Destination-SPACE/Rover/README.md

# Rover
Check out the [wiki](https://github.com/Destination-SPACE/Rover-v1/wiki) for step-by-step instructions.

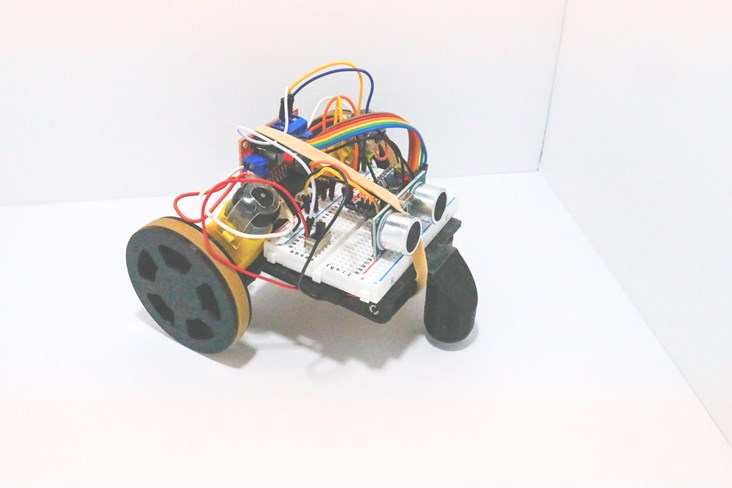
[picture p1: assets/finishedRover.jpg]
