Destination-SPACE/Rover/cad/README.md

# Rover CAD
All of the CAD files for this platform
## STLs
* [Chassis](https://github.com/Destination-SPACE/Rover-v1/tree/main/cad/final_chassis.stl)
* [Wheels](https://github.com/Destination-SPACE/Rover-v1/tree/main/cad/wheel_v4.2.stl)
## Inventor Files
* [Wheels](https://github.com/Destination-SPACE/Rover-v1/tree/main/cad/wheel_v4.2_inv.ipt)
