Destination-SPACE/Rover/code/README.md

# Robot Code
* Sample_3A: Drives forward until distance is < 15cm
* Sample_3B: Drives forward until distance is < 12cm and turns. Set up to be modified to solve maze
