Destination-SPACE/Rover/assets/batteryWires.jpg

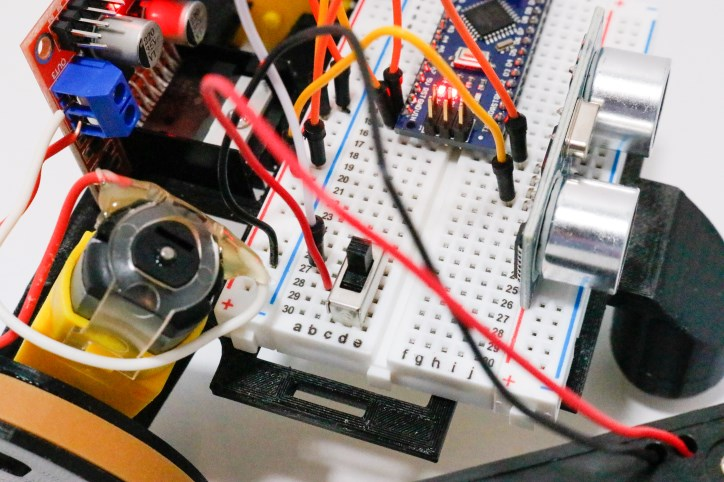
assets/batteryWires.jpg
