Destination-SPACE/Rover/assets/insertingMotors.jpg

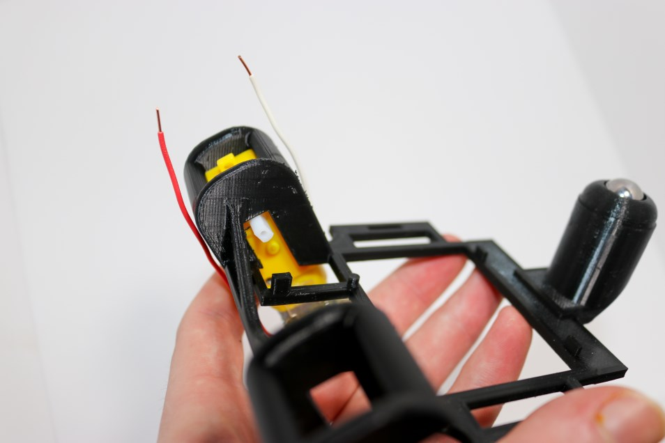
assets/insertingMotors.jpg
