Destination-SPACE/Rover/assets/powerWires.jpg

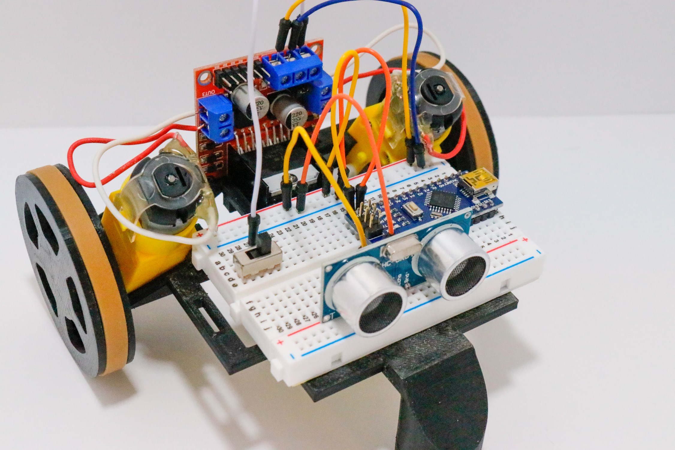
assets/powerWires.jpg
