Destination-SPACE/Rover/assets/schematic.PNG

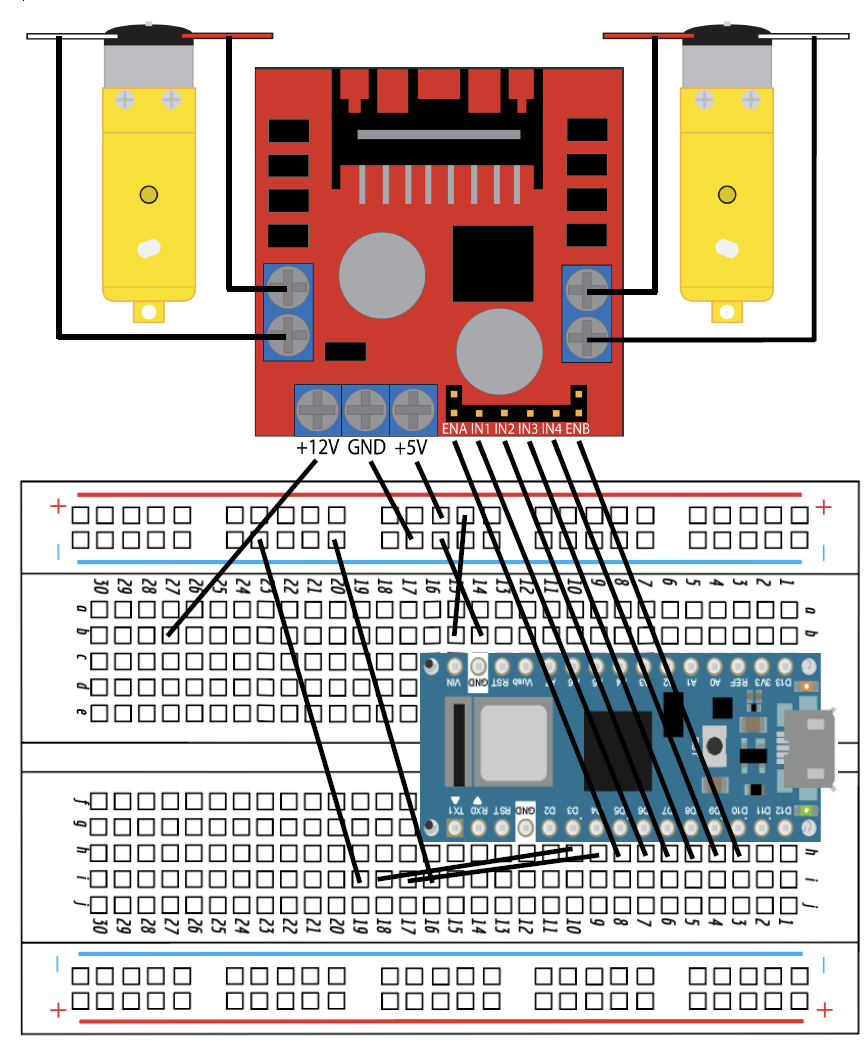
assets/schematic.PNG
