Destination-SPACE/Rover/assets/screwTerminals.jpg

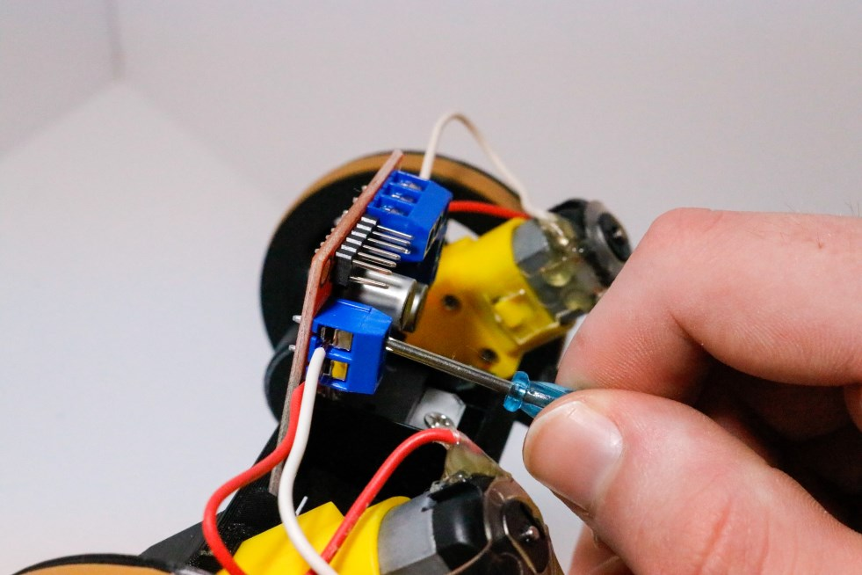
assets/screwTerminals.jpg
