Destination-SPACE/Rover/assets/parts.jpg

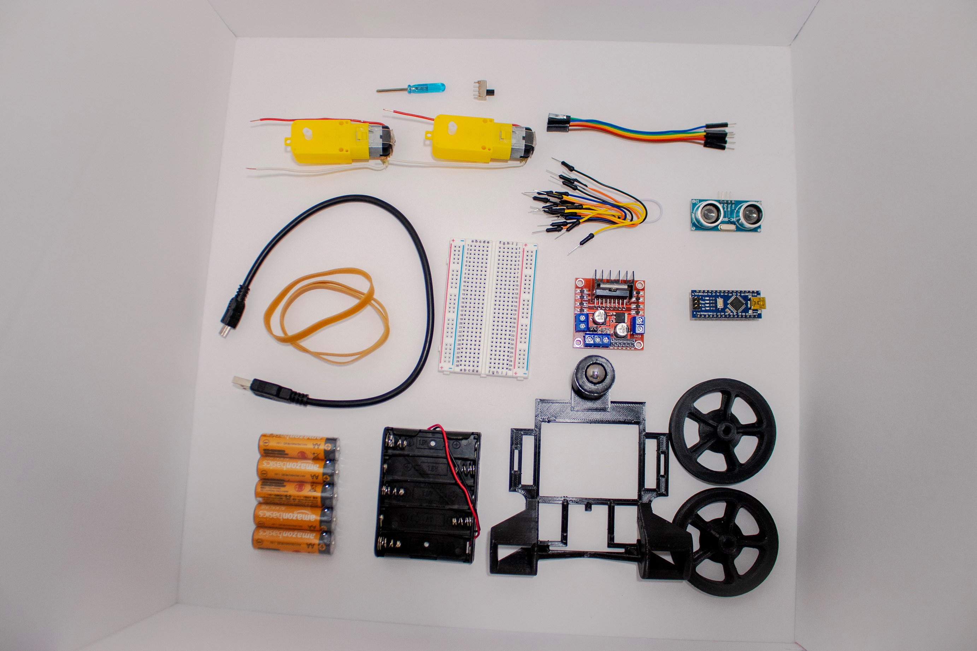
assets/parts.jpg
