Destination-SPACE/Rover/cad/wheel_v4.2.stl

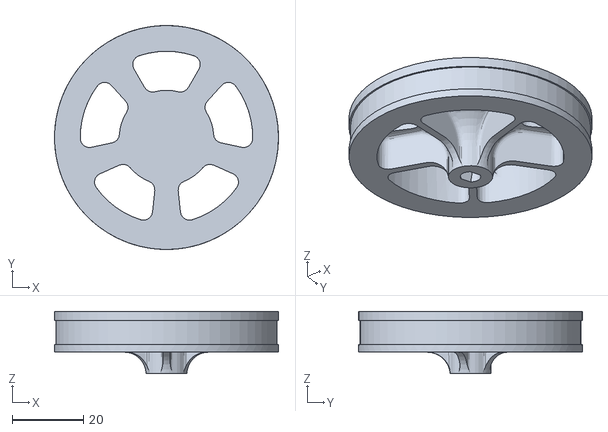
[picture p8: CAD file, 2021-09-08]
cad/wheel_v4.2.stl
62.7 x 62.7 x 17.4
