Destination-SPACE/Rover/cad/final_chassis.stl

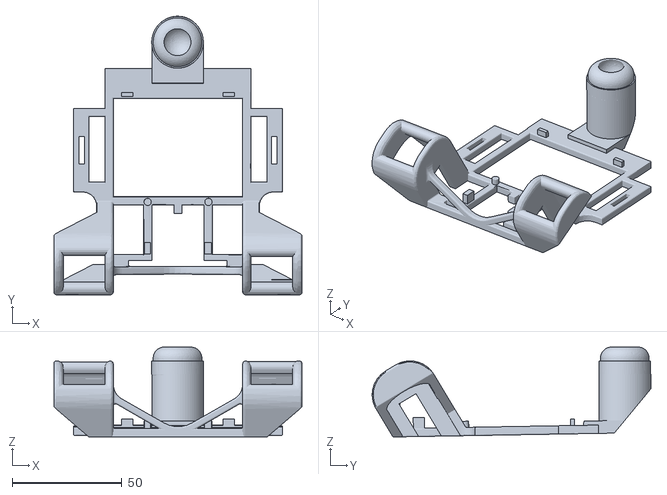
[picture p9: CAD file, 2021-09-08]
cad/final_chassis.stl
113.0 x 127.0 x 41.0
