Destination-SPACE/Rover/(list of files, cad)

Other CAD files:
cad/wheel_v4.2_inv.ipt
