Destination-SPACE/Rover/assets/switchAssembly.jpg

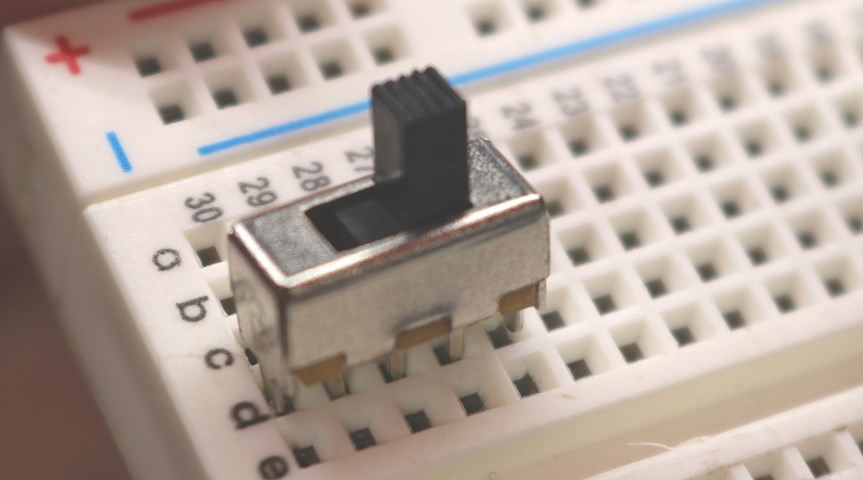
assets/switchAssembly.jpg
